ZeddSerjeant/MotorController/(list of files, drawings)

Other design files:
hardware/design1.dsn
