ZeddSerjeant/MotorController/(commit log)

2020-04-12 more documentation, Initial hardware schematic, functional code that flashes the LED at a particular duty cycle
    [design1.dsn]
2020-04-15 Basic motor control, can set the Duty Cycle in code, modifications to the schematic
    [design1.dsn]
2020-04-22 Proportional control implemented. System now runs at 280Hz and makes measurements each cycle. Changed schematic symbols to be more appropriate
    [design1.dsn]
2020-04-27 Final Report Submitted
    [design1.dsn]
